jgarcia-dec/sensor-calidad-suelo-TEI201/hardware/fotos (OK)/Vista_isométrica.jpg

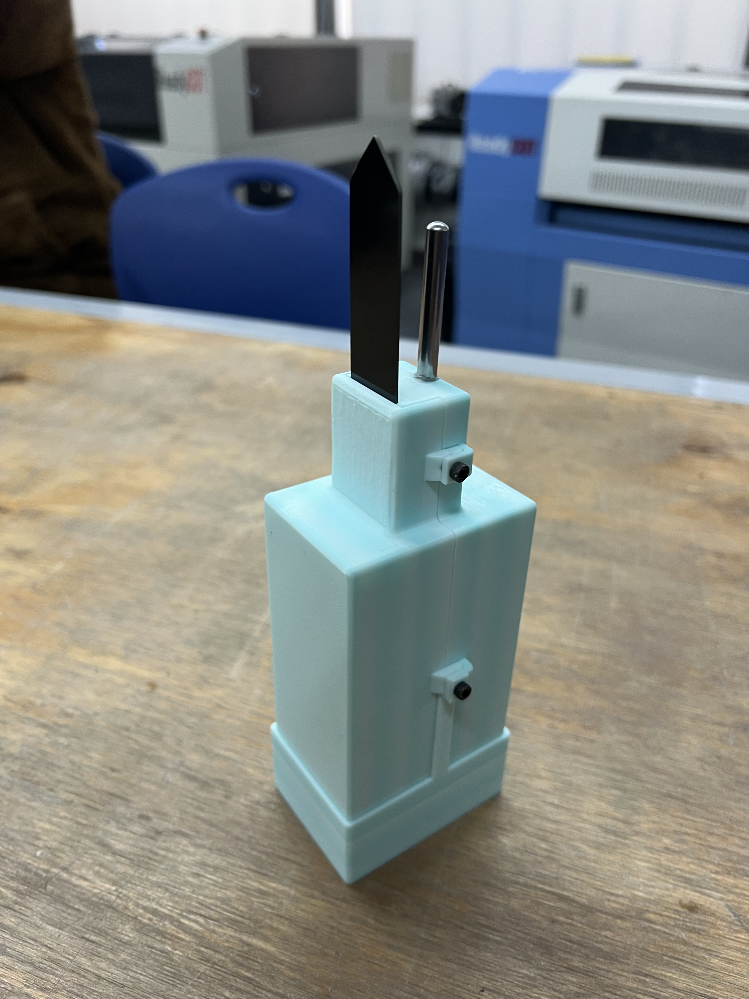
hardware/fotos (OK)/Vista_isométrica.jpg
