jgarcia-dec/sensor-calidad-suelo-TEI201/hardware/fotos (OK)/Vista_general.jpg

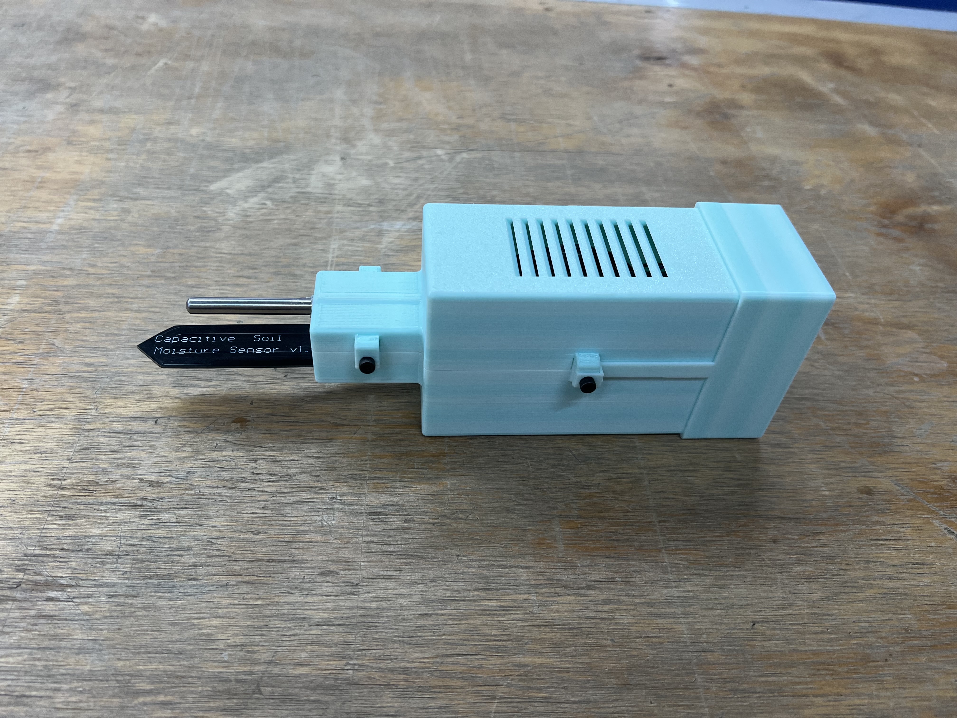
hardware/fotos (OK)/Vista_general.jpg
