jgarcia-dec/sensor-calidad-suelo-TEI201/diseno-3d/renders (OK)/README.md

# Renders de Alta Calidad

## Renders incluidos

### 01_isometrica_exterior_v3.png

Vista isométrica del prototipo completamente ensamblado. Permite observar el encapsulado, la distribución general del sistema y la integración de los componentes electrónicos.

---
  
### 02_vista_interior_v3.png
  
  Vista interna del dispositivo donde se aprecia la ubicación del ESP32-S3, la batería, el sensor capacitivo SEN0193 y el sensor de temperatura DS18B20 dentro del encapsulado.

---
  
### 03_ensamble_explosionada_v3.png
  
  Vista explosionada del sistema que muestra el orden de ensamblaje y la relación entre los distintos componentes mecánicos y electrónicos.

Componentes visibles:
- Encapsulado superior
- Encapsulado inferior
- ESP32-S3 DevKit
- Batería
- Sensor capacitivo SEN0193
- Sensor de temperatura DS18B20
- Protector frontal

---
  
### 04_vista_lateral_v3.png
  
  Vista lateral del dispositivo ensamblado. Permite observar el perfil del encapsulado, la posición del sensor capacitivo y la distribución externa de los componentes.

---
  
### 05_vista_superior_v3.png
  
  Vista superior del prototipo ensamblado. Destaca las ranuras de ventilación del encapsulado y la disposición general del diseño desde la parte superior.

---
  
# Configuración de Render
  
  | Parámetro | Valor |
  |-----------|-------|
  | Software | Autodesk Fusion 360 |
  | Motor de render | Renderizador local |
  | Resolución | 1920 × 1080 px |
  | Calidad | Final |
  | Fondo | Gris neutro |
  | Formato | PNG |
  
  ---
  
# Materiales y Apariencias
  
  | Componente | Material |
  |------------|----------|
  | Encapsulado | PLA |
  | Protector frontal | PLA |
  | ESP32-S3 | PCB FR-4 |
  | Sensor SEN0193 | PCB |
  | Sensor DS18B20 | Acero inoxidable y plástico |
  | Batería | Li-ion |
  
  ---
  
# Nomenclatura de Archivos
  
  ```
01_isometrica_exterior_v3.png
02_vista_interior_v3.png
03_ensamble_explosionada_v3.png
04_vista_lateral_v3.png
05_vista_superior_v3.png
```

---
  
# Checklist de Calidad
  
- ✅ Resolución mínima 1920 × 1080
- ✅ Formato PNG
- ✅ Iluminación uniforme
- ✅ Fondo neutro
- ✅ Vista isométrica exterior
- ✅ Vista interior
- ✅ Vista explosionada
- ✅ Vista lateral
- ✅ Vista superior
- ✅ Componentes principales claramente visibles
