jgarcia-dec/sensor-calidad-suelo-TEI201/diseno-3d/planos/Protector del cableado trasero.pdf

54.1

31.5

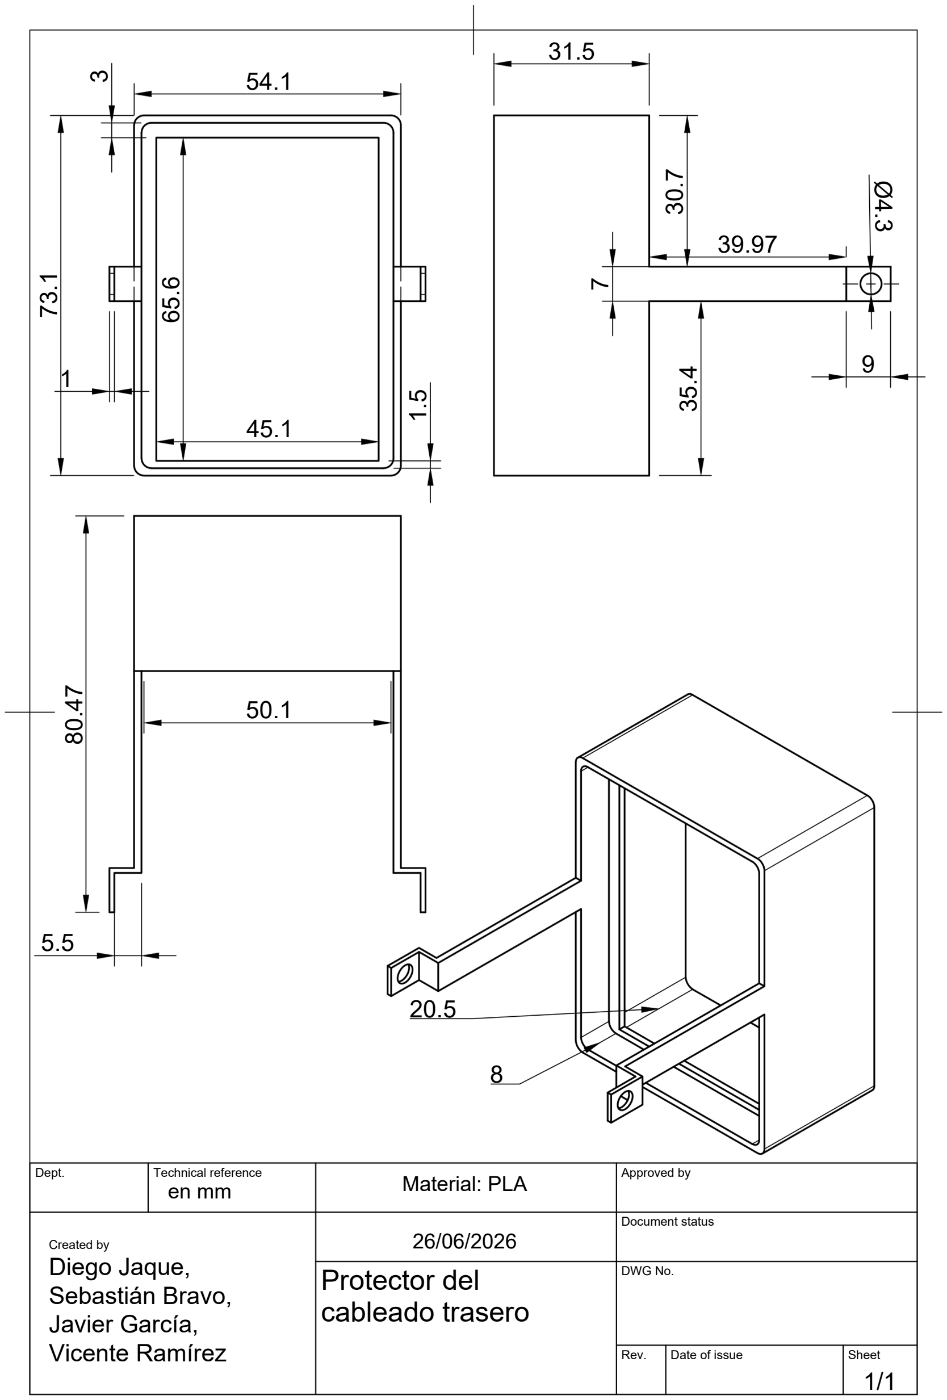
[picture p11: page 1]

Dept. | Technical reference

Rev.

DWG No.

Approved by

Document status

Date of issue | Sheet

1

5.5

50.1

45.1

20.5

8

Created by
Diego Jaque,
Sebastián Bravo,
Javier García,

# Vicente Ramírez

39.97

9

1/1

# Protector del cableado trasero

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
en mm | Material: PLA
| 26/06/2026
