jgarcia-dec/sensor-calidad-suelo-TEI201/diseno-3d/planos/Soporte.pdf.pdf

20.11

2

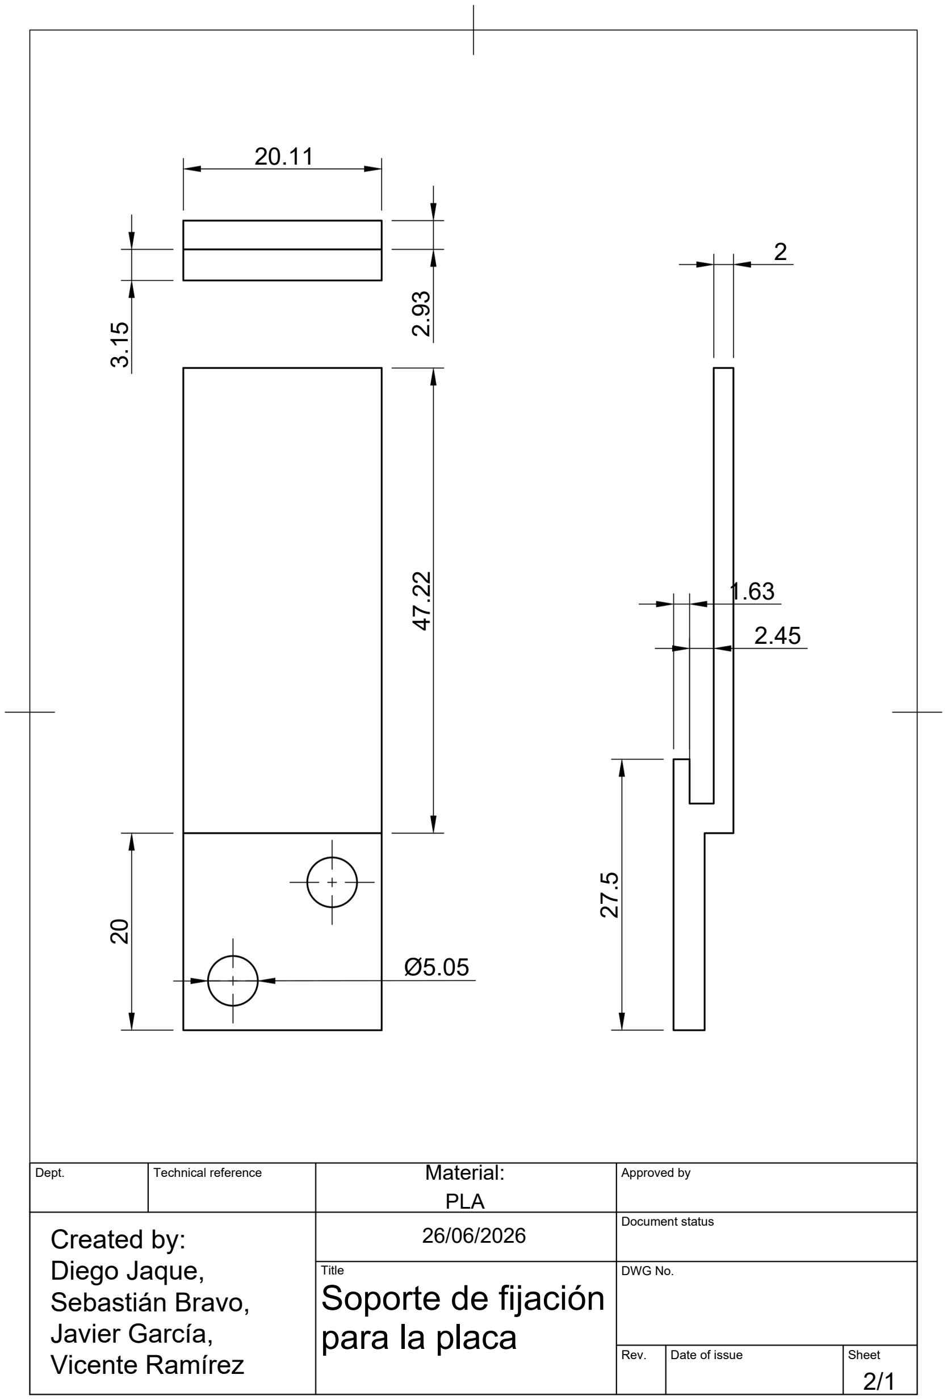
[picture p12: page 1]

Dept. | Technical reference

Rev.

DWG No.

Approved by

Document status

Date of issue | Sheet

Ø5.05

# Created by:

Diego Jaque,
Sebastián Bravo,
Javier García,

# Vicente Ramírez

1.63
2.45

2/1

Title

# Soporte de fijación para la placa

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
## Material: PLA

26/06/2026
