jgarcia-dec/sensor-calidad-suelo-TEI201/diseno-3d/planos/Tapa superior.pdf

5.5

2.3

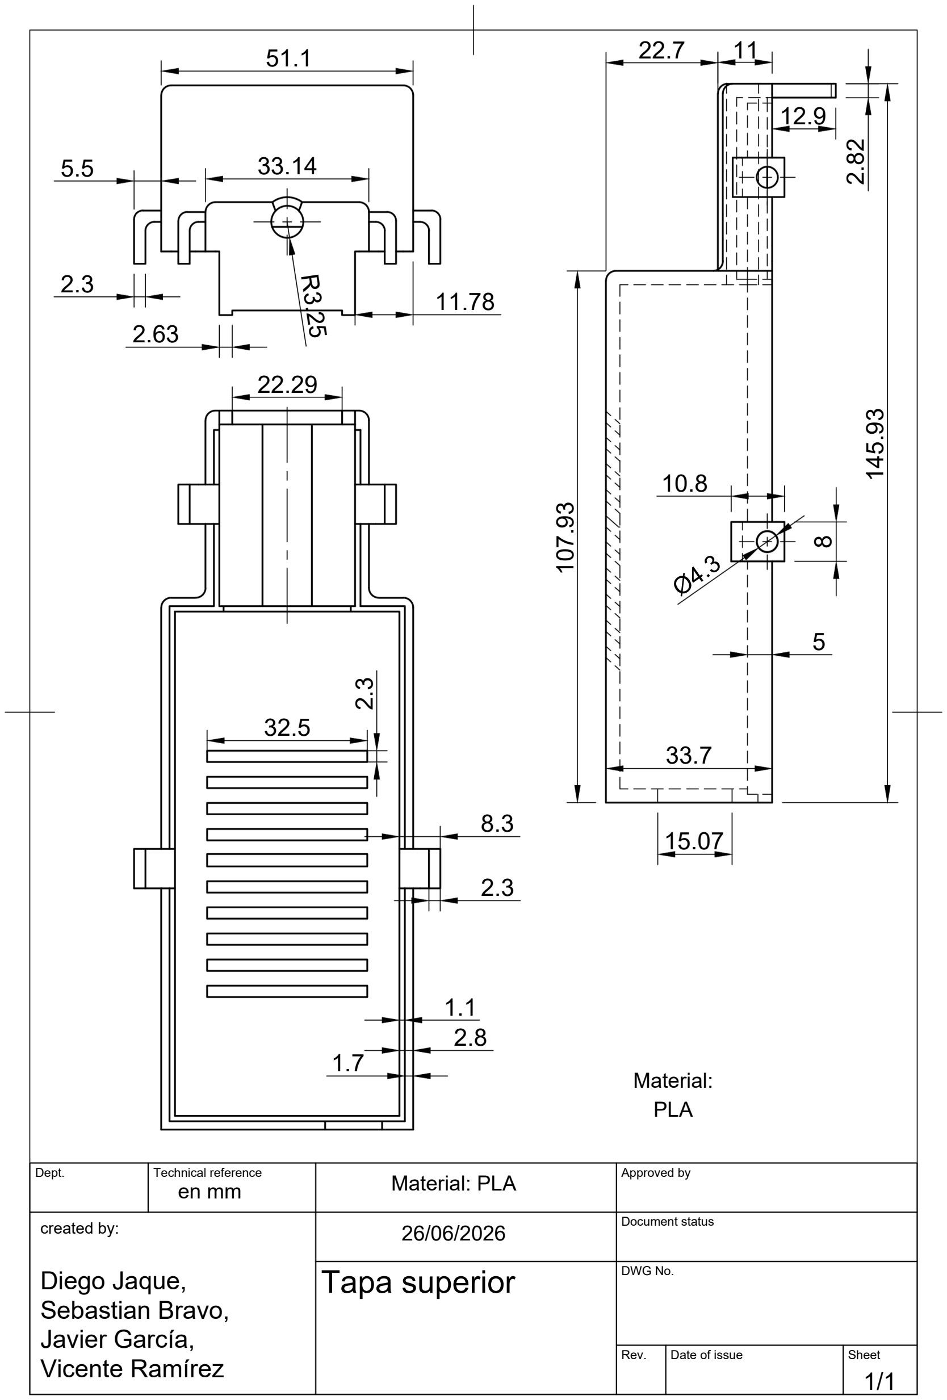
[picture p13: page 1]

Dept. | Technical reference

Rev.

DWG No.

Approved by

Document status

Date of issue | Sheet

2.63

32.5

51.1

33.14

22.29

1.7

1.1
2.8

11.78

8.3

2.3

### created by:

Diego Jaque,
Sebastian Bravo,
Javier García,

# Vicente Ramírez

22.7

10.8

33.7

15.07

5

11

12.9

1/1

# Tapa superior

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
Ø4.3

R3

25

## en mm

26/06/2026

## Material: PLA

## Material: PLA
