jgarcia-dec/sensor-calidad-suelo-TEI201/docs/presentacion/MONITOR_VERDE_V3.pdf

# MONITOR

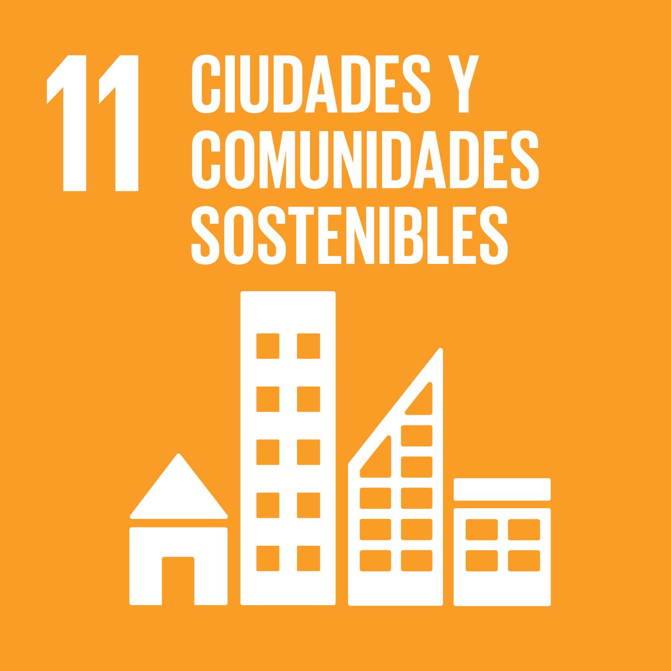
[picture p14: figure]

# VERDE

TEI201 — Taller de Diseño en Ingeniería Design Engineering Center· Universidad Adolfo Ibáñez

Profesor: Sebastián Duarte Villanueva (https://webc.uai.cl/user/profile.php?id=402649) Ayudante: Fernando Mendez Carballo Grupo: 2
Integrantes:
- Sebastián Bravo
- Javier García
- Diego Jaque
- Vicente Ramírez

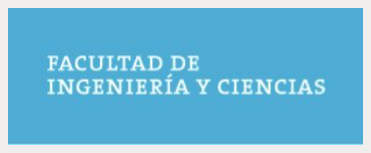
[picture p15: figure]
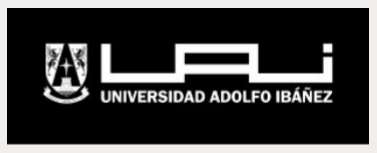
[picture p16: figure]

# PROBLEMA

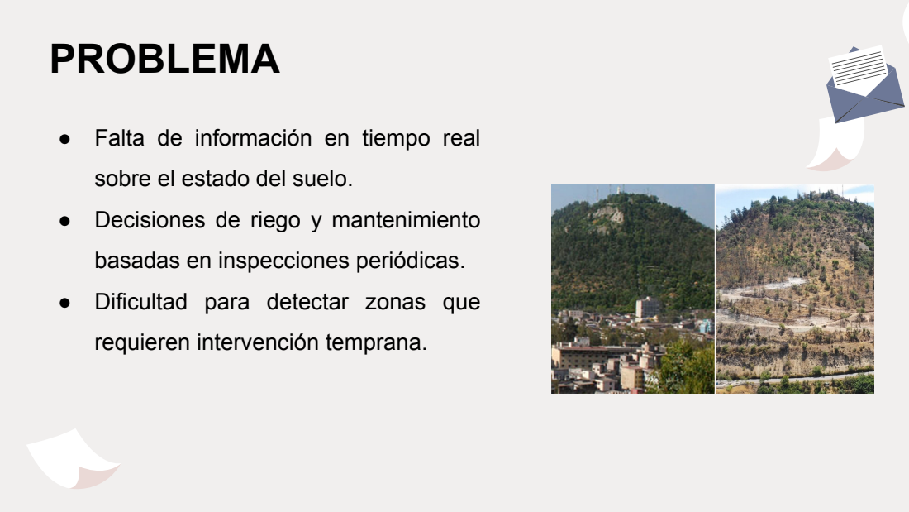
[picture p17: page 2]

● Falta de información en tiempo real

sobre el estado del suelo.

● Decisiones de riego y mantenimiento

basadas en inspecciones periódicas.
● Dificultad para detectar zonas que

requieren intervención temprana.

# PROBLEMA

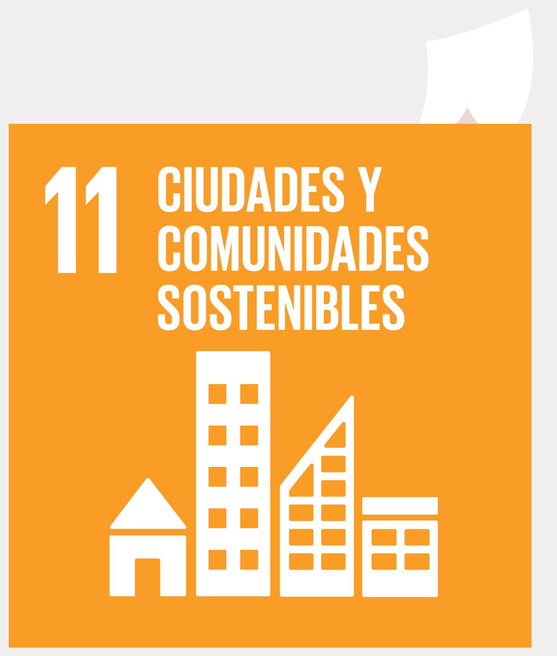
[picture p18: figure]
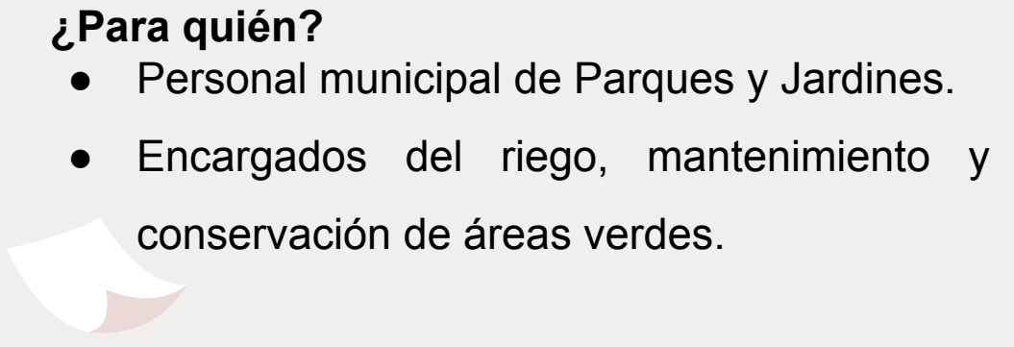
[picture p19: figure]
¿Para quién?; ● Encargados del riego, mantenimiento y; conservación de áreas verdes.

- Personal municipal de Parques y Jardines.

¿Qué resolvemos?
- Monitoreo en tiempo real de humedad y

temperatura del suelo.

- Apoyo a la toma de decisiones basada en datos.

# SOLUCIÓN

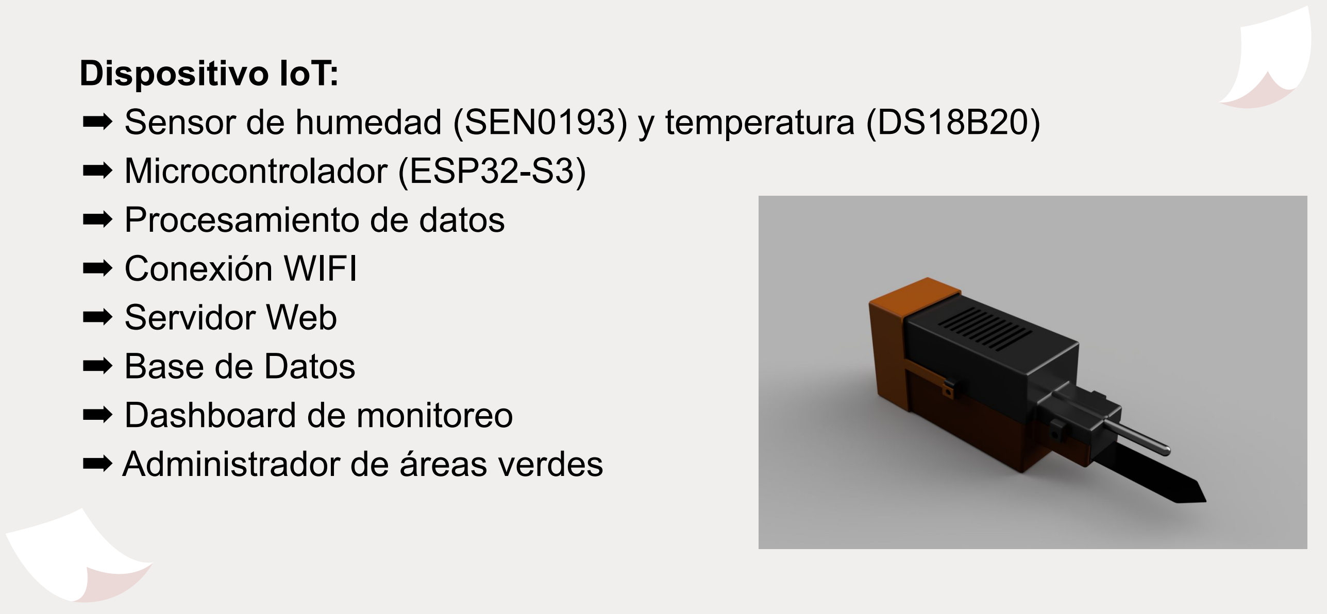
[picture p20: figure]
Dispositivo IoT:; ➡ Microcontrolador (ESP32-S3) ➡ Procesamiento de datos ➡ Conexión WIFI ➡ Servidor Web ➡ Base de Datos ➡ Dashboard de monitoreo ➡ Administrador de áreas verdes

➡ Sensor de humedad (SEN0193) y temperatura (DS18B20)

# HARDWARE

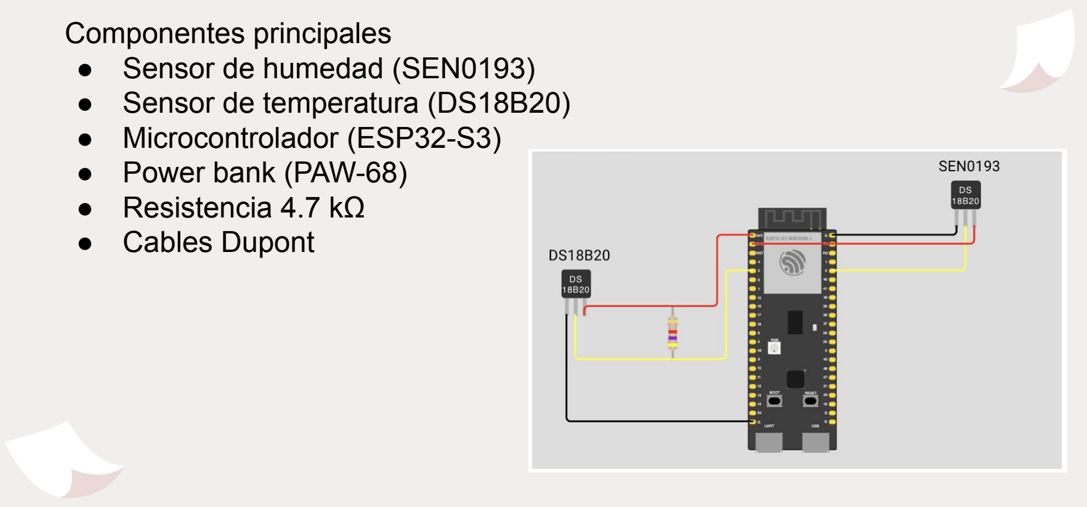
[picture p21: figure]
Componentes principales ● Sensor de humedad (SEN0193) ● Sensor de temperatura (DS18B20) ● Microcontrolador (ESP32-S3) ● Power bank (PAW-68) ● Resistencia 4.7 kΩ ● Cables Dupont

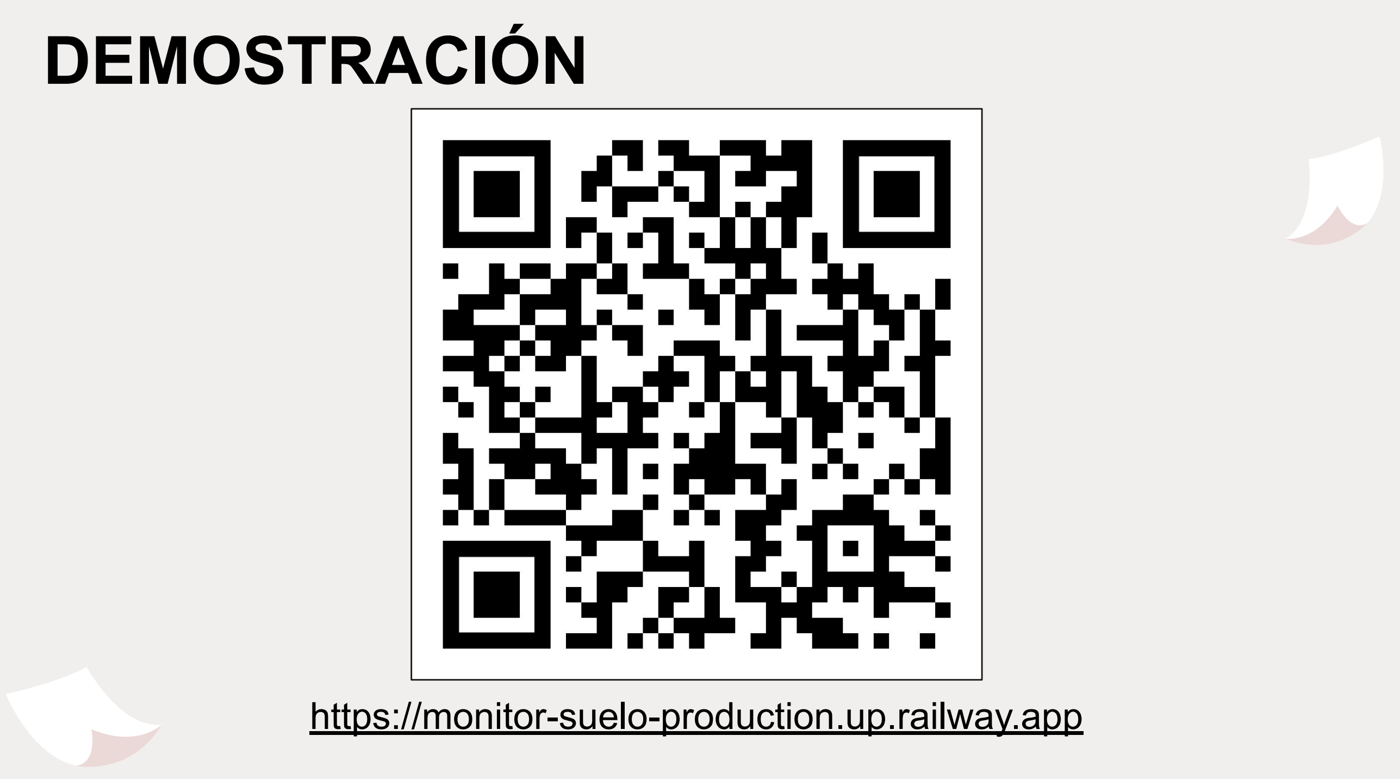
[picture p22: figure]
DEMOSTRACIÓN; https://monitor-suelo-production.up.railway.app

# DISEÑO 3D

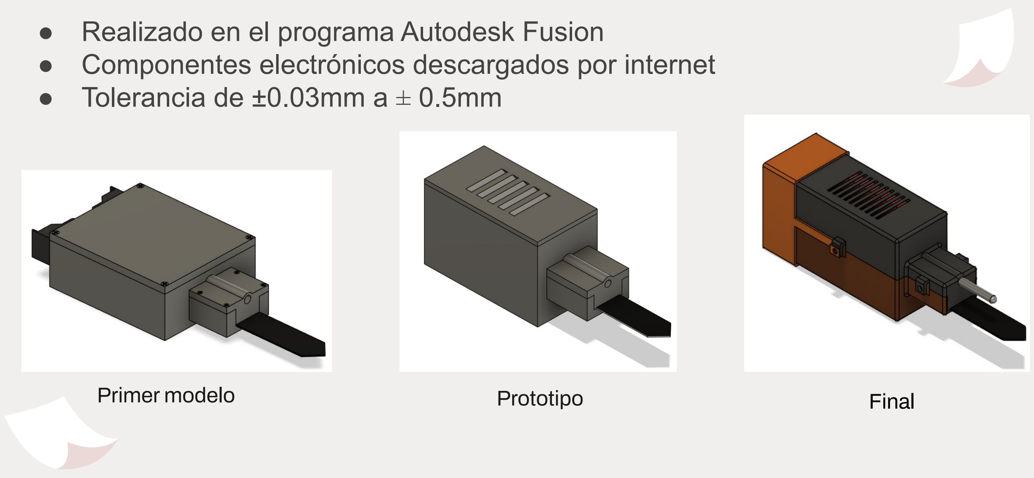
[picture p23: figure]
Primer modelo; Prototipo; Final; ● Tolerancia de ±0.03mm a ± 0.5mm

- Realizado en el programa Autodesk Fusion
- Componentes electrónicos descargados por internet

# MODELOS 3D

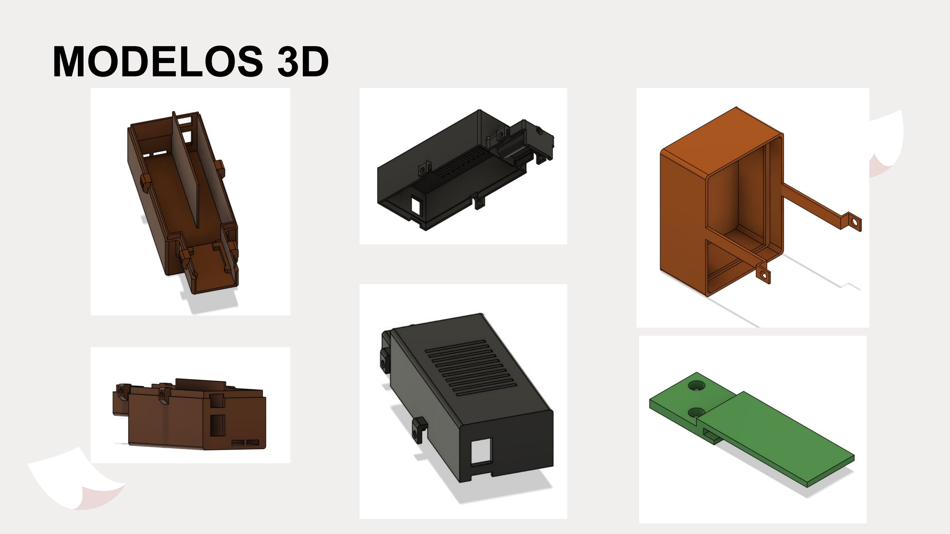
[picture p24: page 8]
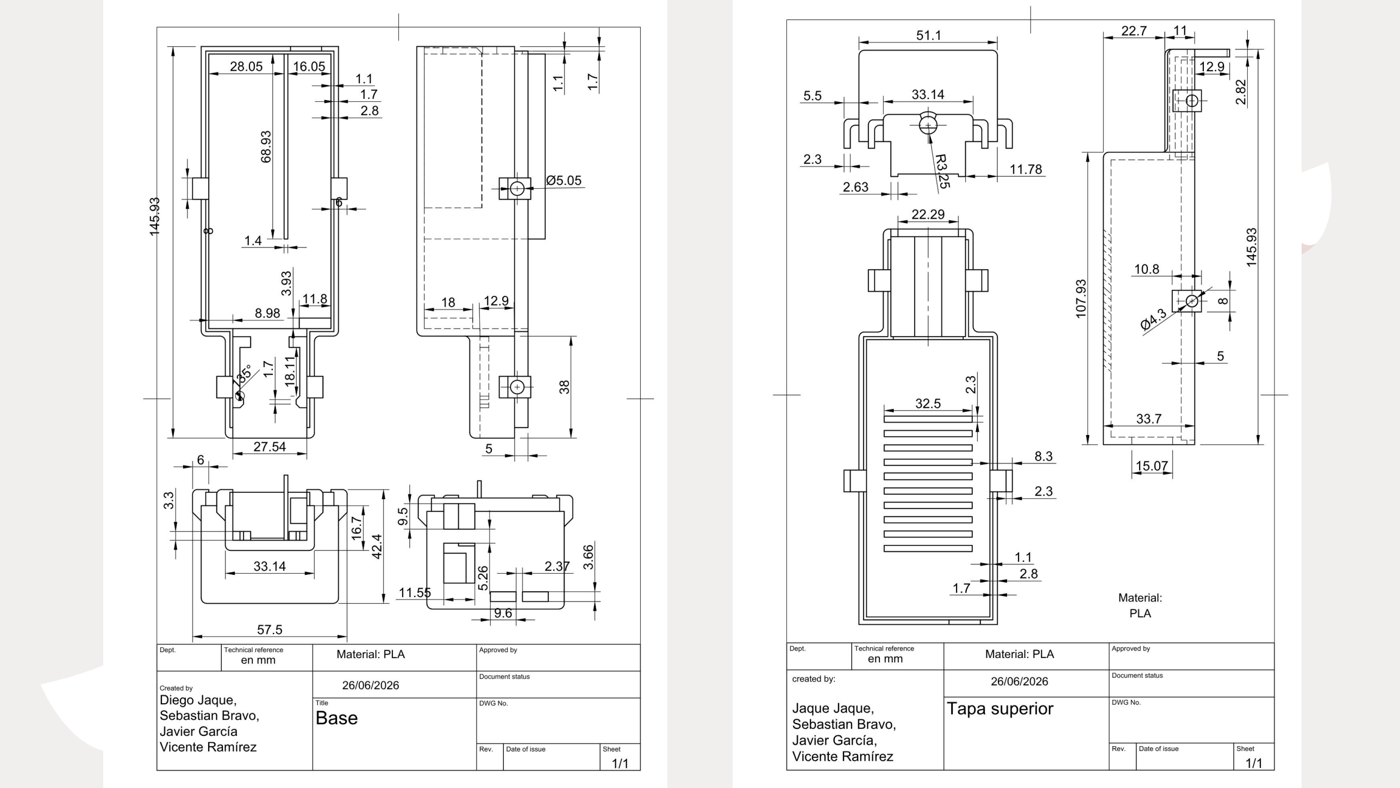
[picture p25: page 9]
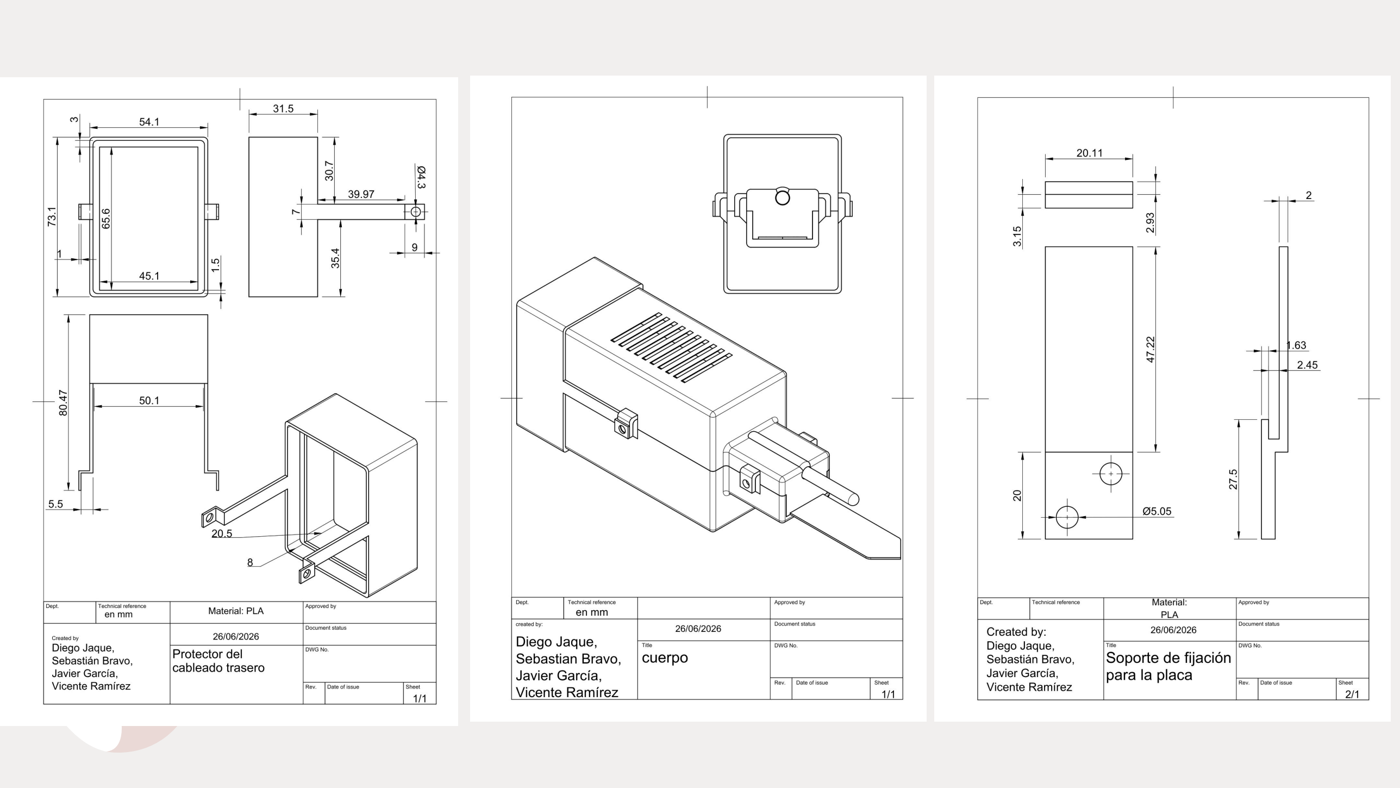
[picture p26: page 10]

# GITHUB

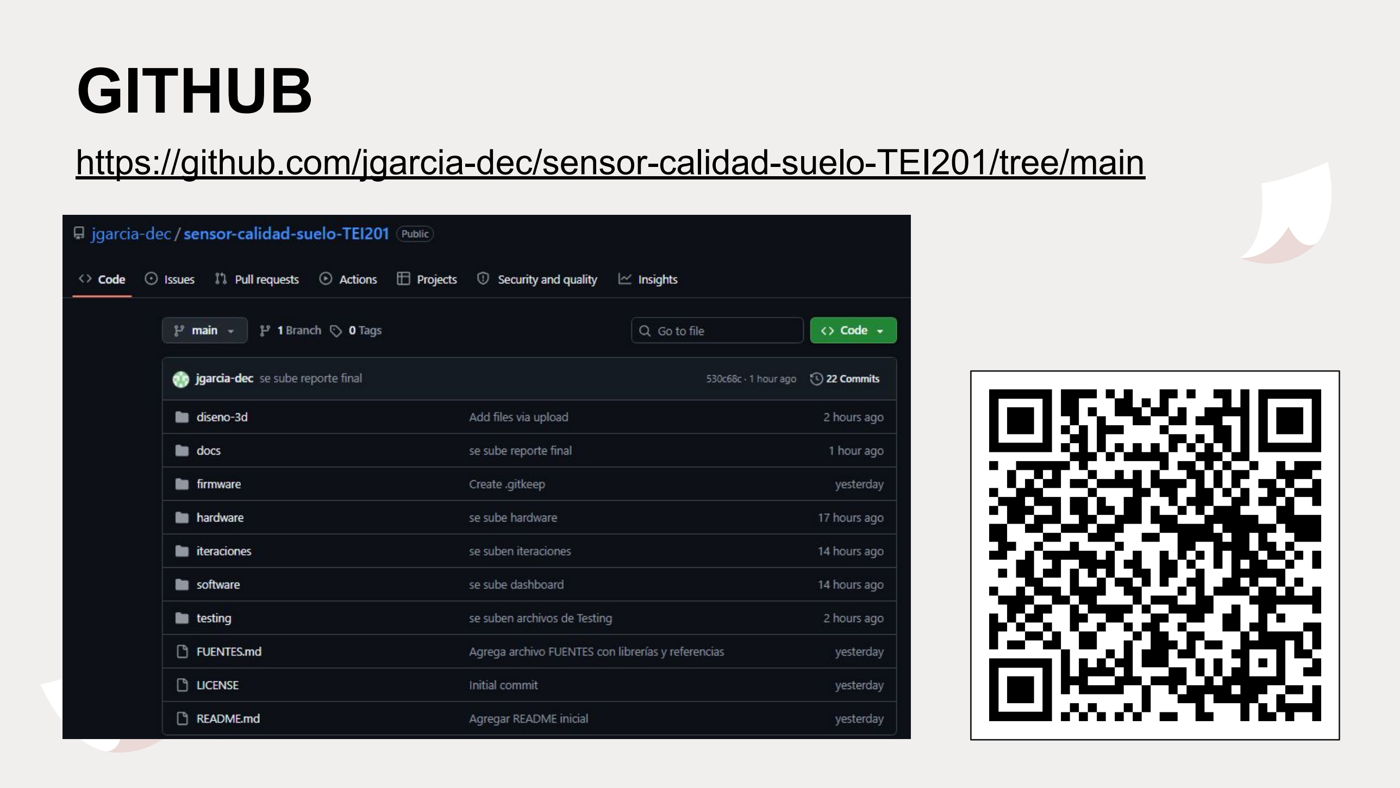
[picture p27: page 11]

https://github.com/jgarcia-dec/sensor-calidad-suelo-TEI201/tree/main

# Librerias de codigo

1. Arduino: Provee las funciones más esenciales como setup(), loop(), digitalWrite(), delay(), etc. Sin ella, el código no funciona.
2. OneWire: Este protocolo permite conectar múltiples sensores usando un solo cable de datos
3. DallasTemperature: esta librería facilita la lectura del sensor de temperatura DS18B20
4. WiFi: Permite conectar el ESP32 a una red WiFi
5. HTTPClient: Facilita hacer peticiones HTTP (como POST o GET) desde el ESP32 hacia un servidor
6. WiFiClientSecure: Es una versión extendida del cliente WiFi que soporta conexiones HTTPS (cifradas con SSL/TLS). Se usa cuando el servidor al que te conectas tiene un certificado de seguridad, como ocurre cuando el servidor está en la nube o detrás de un dominio con https://.

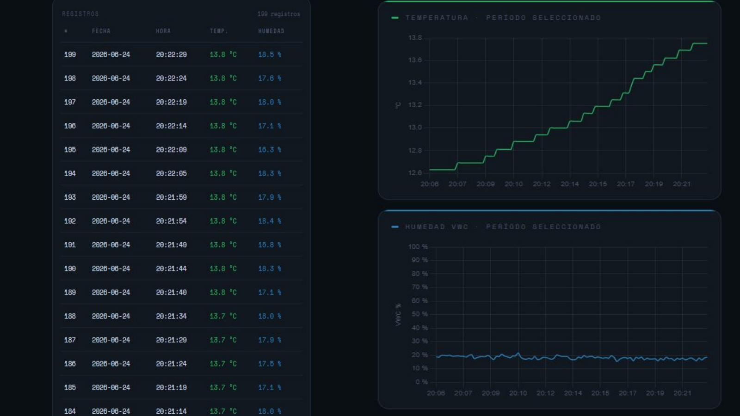
[picture p28: page 13]
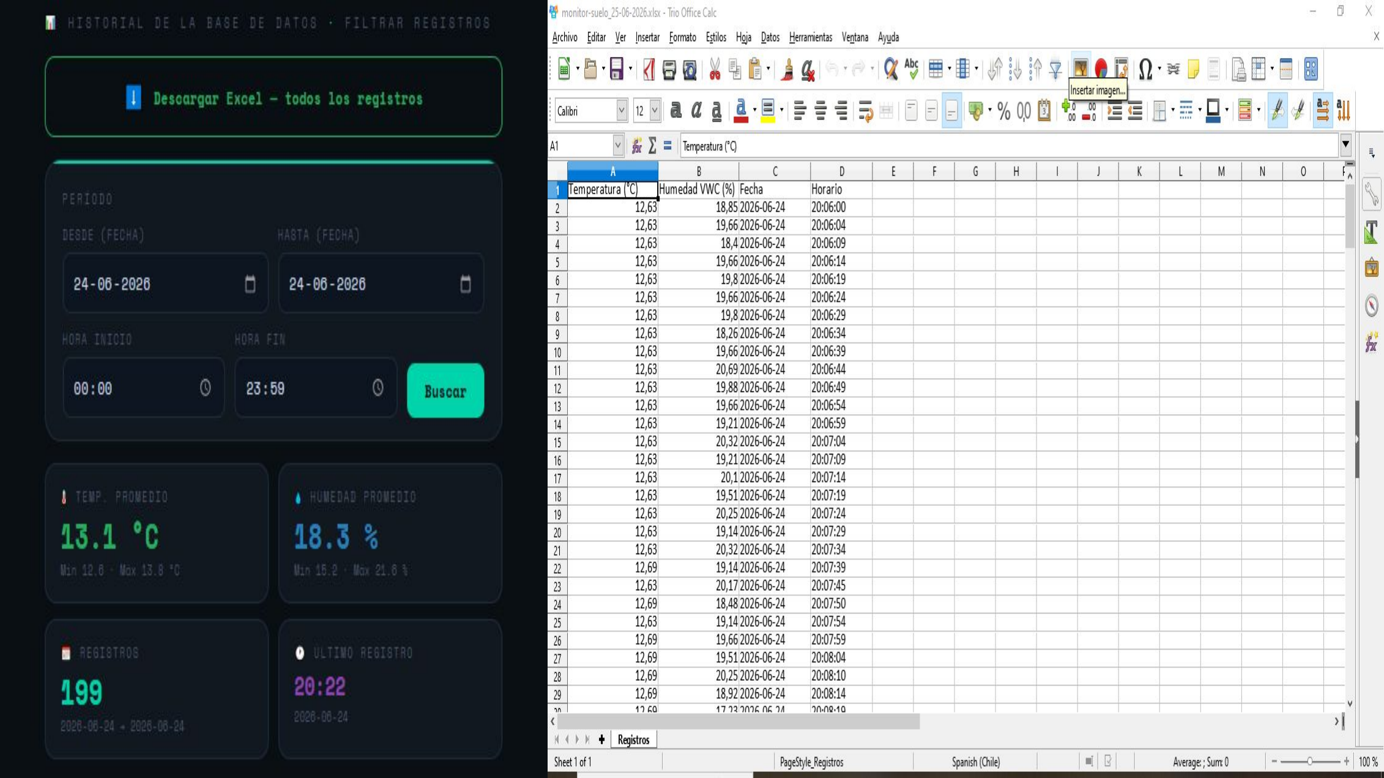
[picture p29: page 14]

# ¿PREGUNTAS?
