jgarcia-dec/sensor-calidad-suelo-TEI201/diseno-3d/planos/Base.pdf

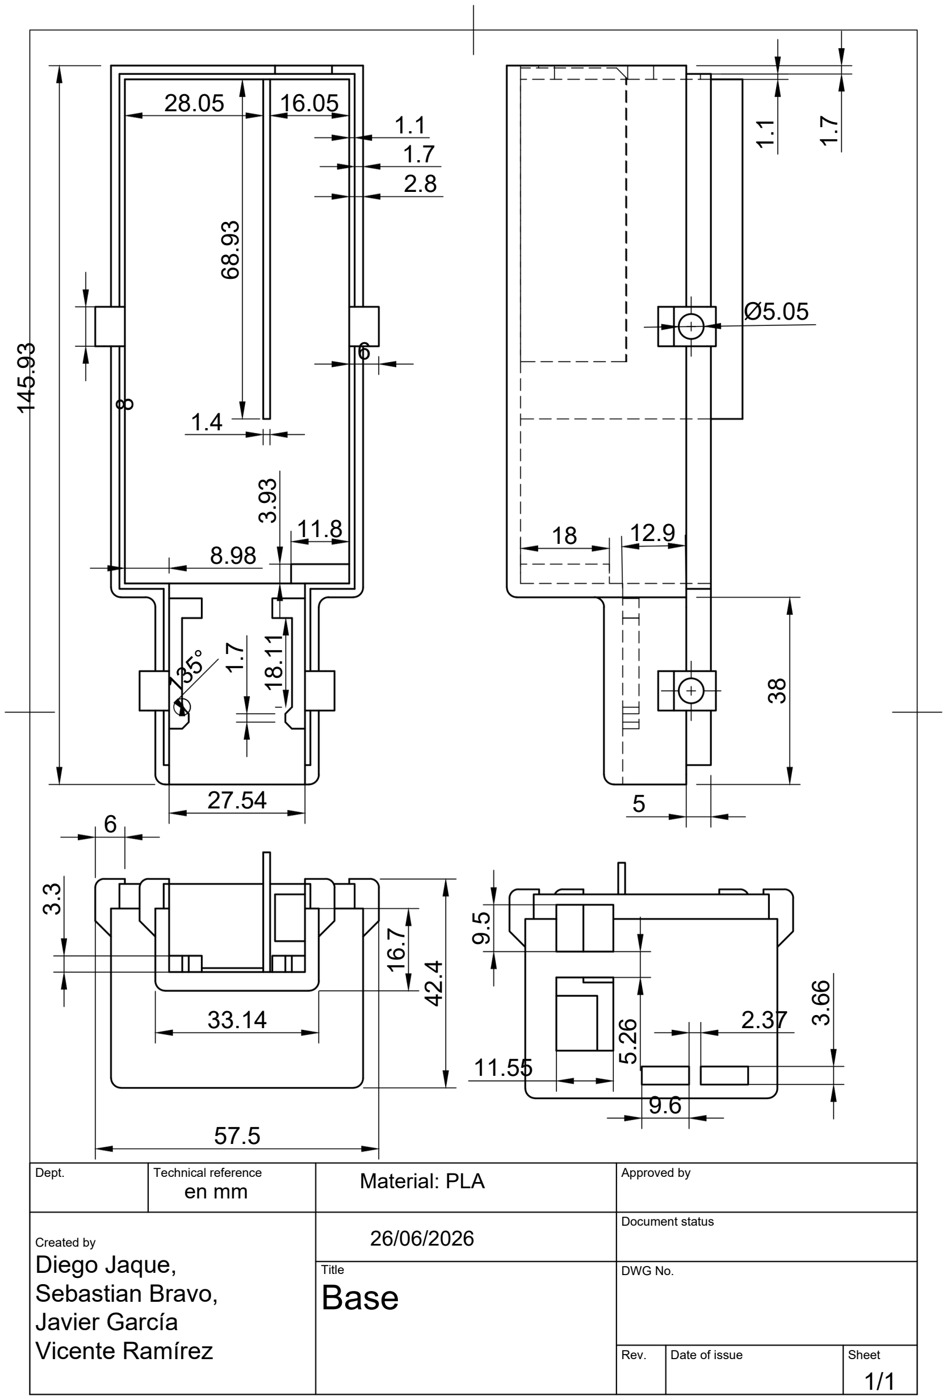
[picture p43: page 1]

Dept. | Technical reference

Rev.

DWG No.

Approved by

Document status

Date of issue | Sheet

6

1.4

28.05

8.98

57.5

33.14

27.54

16.05

11.8

6

1.1
1.7
2.8

11.55

18

Created by
Diego Jaque,
Sebastian Bravo,
Javier García
Vicente Ramírez

5

12.9

9.6

2.37

Ø5.05

1/1

Title

## Base

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
135°

en mm

Material: PLA

26/06/2026
