jgarcia-dec/sensor-calidad-suelo-TEI201/iteraciones/iteracion-1/v1_circuito_protoboard.jpeg

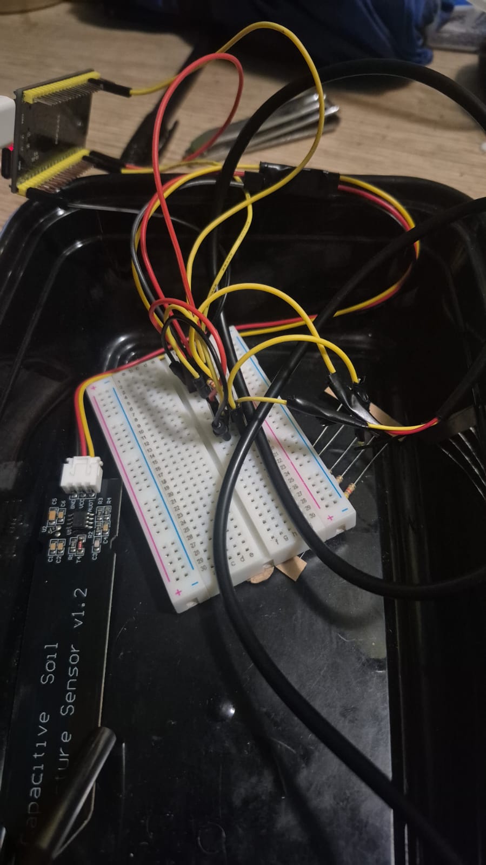
iteraciones/iteracion-1/v1_circuito_protoboard.jpeg
