jgarcia-dec/sensor-calidad-suelo-TEI201/iteraciones/iteracion-1/v1_detalle_conexiones.jpeg

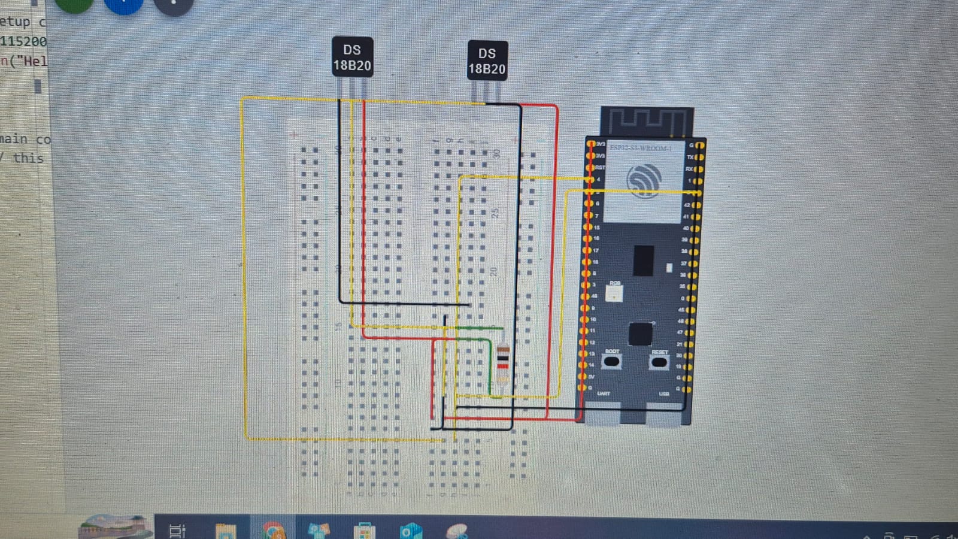
iteraciones/iteracion-1/v1_detalle_conexiones.jpeg
