jgarcia-dec/sensor-calidad-suelo-TEI201/iteraciones/iteracion-2/v2_cuerpo_superior.jpeg

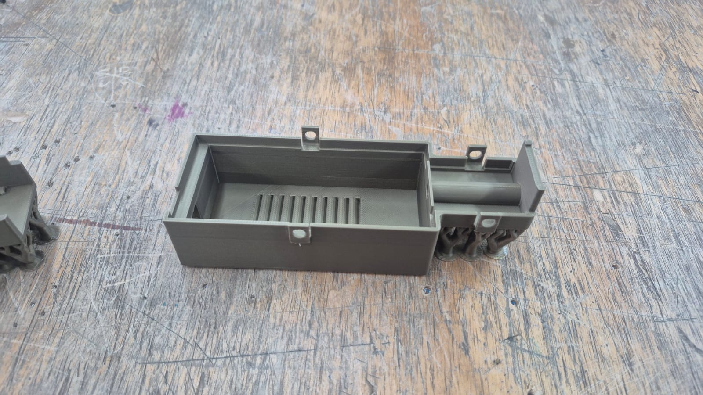
iteraciones/iteracion-2/v2_cuerpo_superior.jpeg
