jgarcia-dec/sensor-calidad-suelo-TEI201/iteraciones/iteracion-2/v2_detalle_conexiones.jpeg

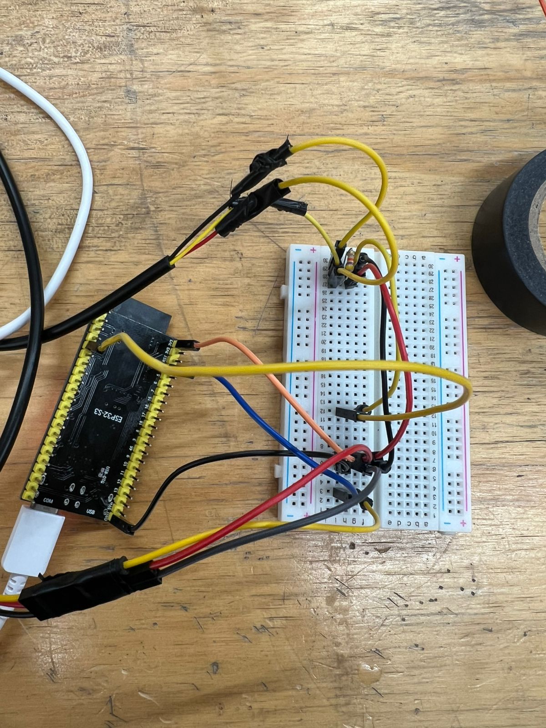
iteraciones/iteracion-2/v2_detalle_conexiones.jpeg
