jgarcia-dec/sensor-calidad-suelo-TEI201/iteraciones/iteracion-3/v3_prototipo_superior.jpg

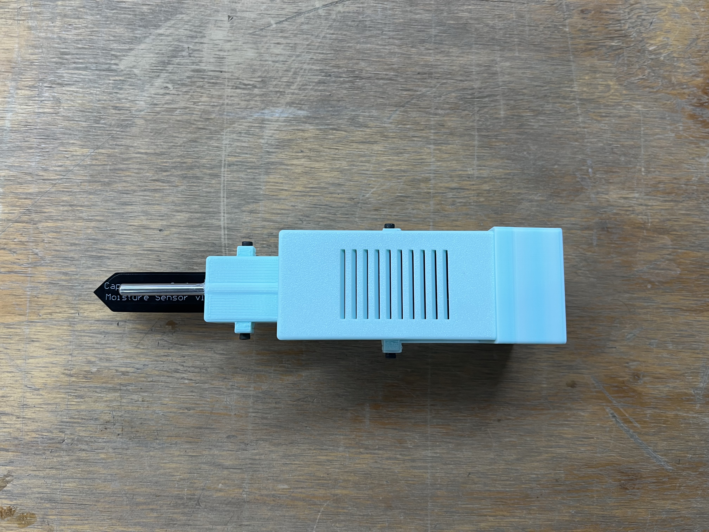
iteraciones/iteracion-3/v3_prototipo_superior.jpg
