jgarcia-dec/sensor-calidad-suelo-TEI201/software/Docs (OK)/diagrama.png

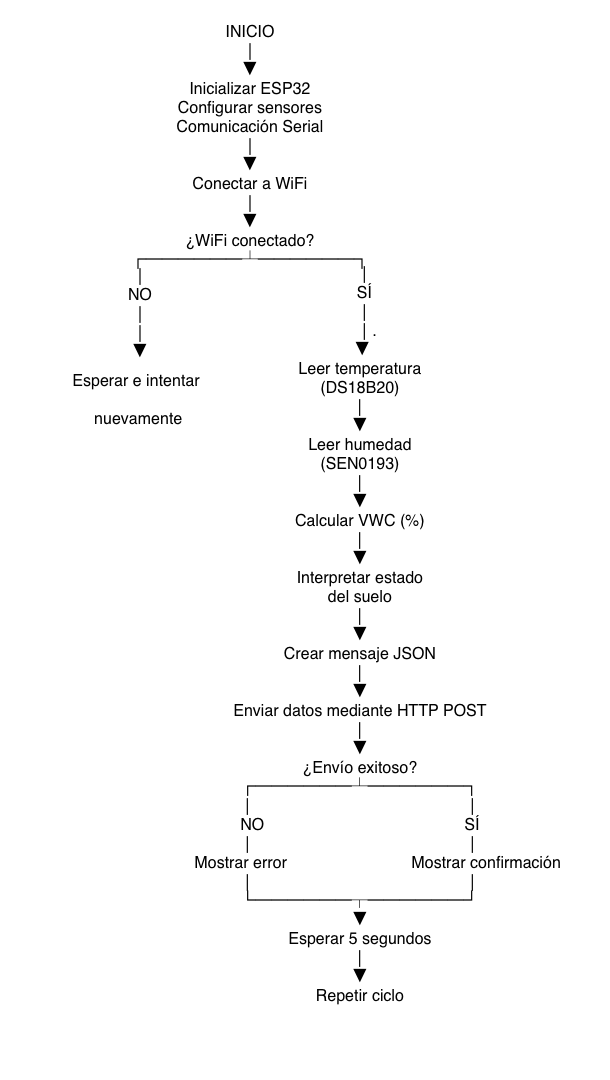
software/Docs (OK)/diagrama.png
