jgarcia-dec/sensor-calidad-suelo-TEI201/hardware/bom (OK)/BOM  (Software).xlsx

BILL OF MATERIALS (BOM) |  | Ítem | Componente | Fabricante | Código / SKU | Proveedor | Especificación | Cantidad | Costo unitario (CLP) | Costo total (CLP)
Proyecto: | Sensor IoT de Humedad y Temperatura del Suelo | 1 | ESP32 | Espressif |  | Universidad Adolfo Ibáñez | Microcontrolador con WiFi y Bluetooth, alimentación 3.3 V | 1 | $8000 | $8000
Versión: | 1.0 | 2 | Sensor de humedad de suelo | DFRobot | SEN0193 | Universidad Adolfo Ibáñez | Sensor capacitivo v1.2, alimentación 3.3–5.0 V, salida analógica | 1 | $2776 | $2776
Fecha: | 25 de junio de 2026 | 3 | Sensor de temperatura | Maxim Integrated | DS18B20 | Universidad Adolfo Ibáñez | DS18B20, alimentación 3.0–5.5 V, rango −55 °C a 125 °C | 1 | $2500 | $2500
Curso: | Taller de Diseño en Ingeniería, Sección 2 | 4 | Módulo de alimentación |  | PAW-68 | Universidad Adolfo Ibáñez | PAW-68, batería/cargador portátil, voltaje nominal 3.7 V | 1 | $7990 | $7990
Institución: | Universidad Adolfo Ibañez | 5 | Resistencia | No aplica | No aplica | Universidad Adolfo Ibáñez | 4.7 kΩ (4700 Ω), 1/4 W, ±5 % | 1 | $1098 | $1098
Docente: | Sebastián Duarte | 6 | Cable USB | No aplica | No aplica | Universidad Adolfo Ibáñez | USB-A a USB-C para alimentación y programación | 1 | $1000 | $1000
Responsables: | Ramírez V., Bravo S., García J., Jaque D. | 7 | Cable Dupont | No aplica | No aplica | Universidad Adolfo Ibáñez | Cable de conexión macho-hembra | 6 | $50 | $300
 |  |  |  |  |  |  |  |  | TOTAL | $23664
