jgarcia-dec/sensor-calidad-suelo-TEI201/hardware/bom (OK)/BOM .pdf

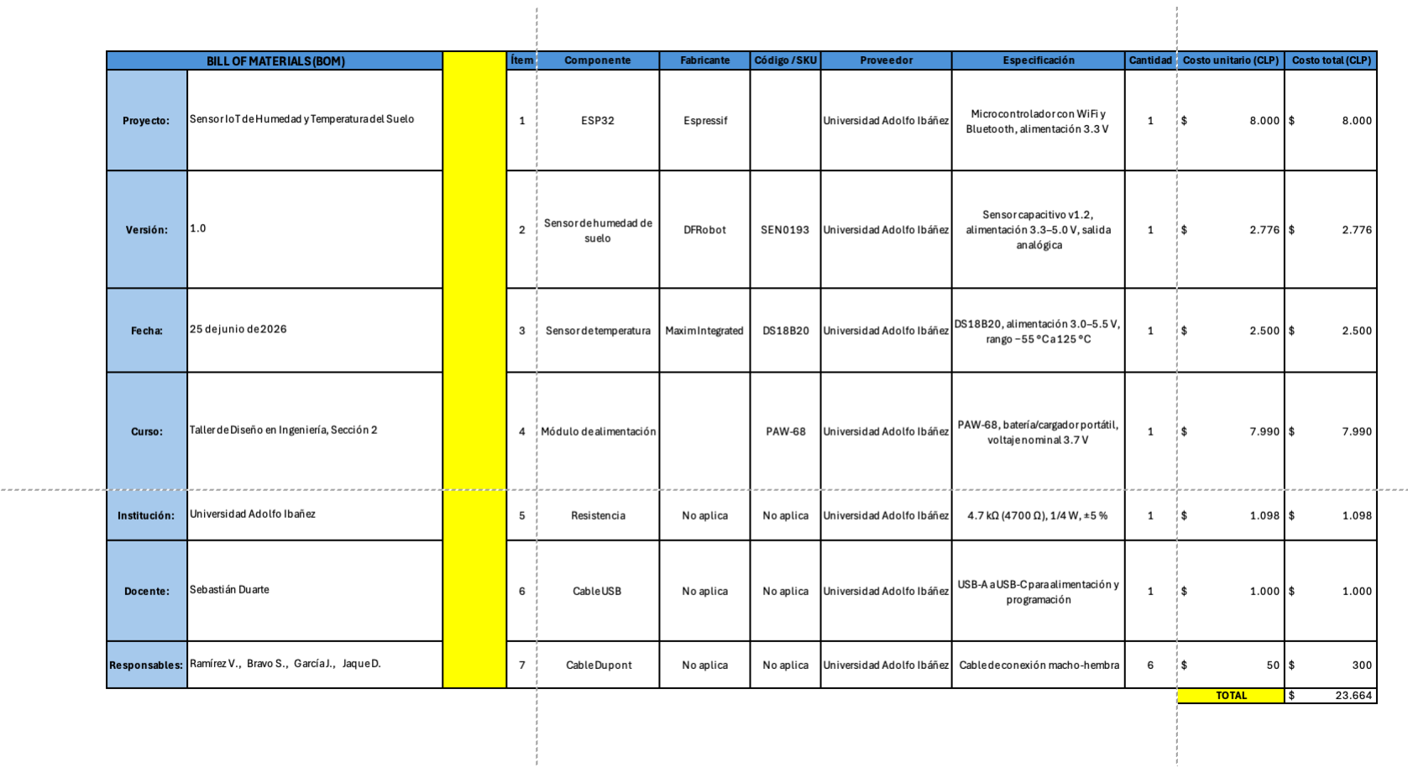
[picture p55: page 1]
