jgarcia-dec/sensor-calidad-suelo-TEI201/iteraciones/iteracion-3/v3_componentes_internos.jpeg

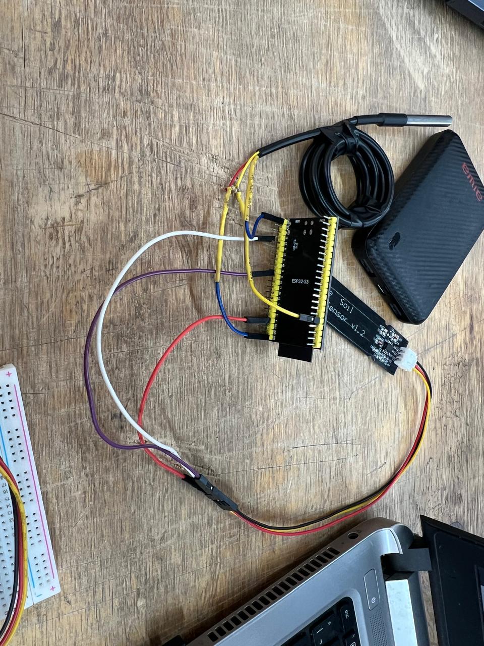
iteraciones/iteracion-3/v3_componentes_internos.jpeg
