jgarcia-dec/sensor-calidad-suelo-TEI201/diseno-3d/renders (OK)/renders_fusion/03_ensamble_explosionada_v3.png

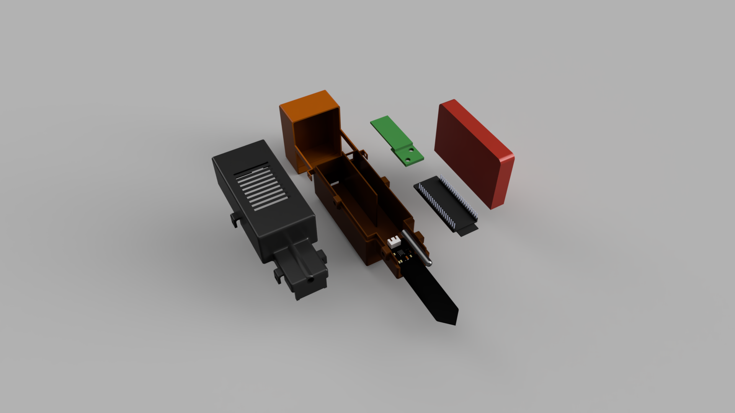
diseno-3d/renders (OK)/renders_fusion/03_ensamble_explosionada_v3.png
