jgarcia-dec/sensor-calidad-suelo-TEI201/testing/Datos/monitor-suelo_25-06-2026.xlsx

Temperatura (°C) | Humedad VWC (%) | Fecha | Horario
12.63 | 18.85 | 2026-06-24 | 20:06:00
12.63 | 19.66 | 2026-06-24 | 20:06:04
12.63 | 18.4 | 2026-06-24 | 20:06:09
12.63 | 19.66 | 2026-06-24 | 20:06:14
12.63 | 19.8 | 2026-06-24 | 20:06:19
12.63 | 19.66 | 2026-06-24 | 20:06:24
12.63 | 19.8 | 2026-06-24 | 20:06:29
12.63 | 18.26 | 2026-06-24 | 20:06:34
12.63 | 19.66 | 2026-06-24 | 20:06:39
12.63 | 20.69 | 2026-06-24 | 20:06:44
12.63 | 19.88 | 2026-06-24 | 20:06:49
12.63 | 19.66 | 2026-06-24 | 20:06:54
12.63 | 19.21 | 2026-06-24 | 20:06:59
12.63 | 20.32 | 2026-06-24 | 20:07:04
12.63 | 19.21 | 2026-06-24 | 20:07:09
12.63 | 20.1 | 2026-06-24 | 20:07:14
12.63 | 19.51 | 2026-06-24 | 20:07:19
12.63 | 20.25 | 2026-06-24 | 20:07:24
12.63 | 19.14 | 2026-06-24 | 20:07:29
12.63 | 20.32 | 2026-06-24 | 20:07:34
12.69 | 19.14 | 2026-06-24 | 20:07:39
12.63 | 20.17 | 2026-06-24 | 20:07:45
12.69 | 18.48 | 2026-06-24 | 20:07:50
12.63 | 19.14 | 2026-06-24 | 20:07:54
12.69 | 19.66 | 2026-06-24 | 20:07:59
12.69 | 19.51 | 2026-06-24 | 20:08:04
12.69 | 20.25 | 2026-06-24 | 20:08:10
12.69 | 18.92 | 2026-06-24 | 20:08:14
12.69 | 17.23 | 2026-06-24 | 20:08:19
12.69 | 18.85 | 2026-06-24 | 20:08:24
12.69 | 18.18 | 2026-06-24 | 20:08:29
12.69 | 20.69 | 2026-06-24 | 20:08:34
12.69 | 18.77 | 2026-06-24 | 20:08:39
12.69 | 17.96 | 2026-06-24 | 20:08:44
12.69 | 18.85 | 2026-06-24 | 20:08:49
12.75 | 18.4 | 2026-06-24 | 20:08:54
12.69 | 18.85 | 2026-06-24 | 20:08:59
12.69 | 19.36 | 2026-06-24 | 20:09:04
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
13.75 | 17.89 | 2026-06-24 | 20:21:59
13.75 | 18.26 | 2026-06-24 | 20:22:05
13.75 | 16.34 | 2026-06-24 | 20:22:09
13.75 | 17.08 | 2026-06-24 | 20:22:14
13.75 | 17.96 | 2026-06-24 | 20:22:19
13.75 | 17.59 | 2026-06-24 | 20:22:24
13.75 | 18.48 | 2026-06-24 | 20:22:29
