jgarcia-dec/sensor-calidad-suelo-TEI201/testing/Evidencias/Dashboard_1-mediciones.jpeg

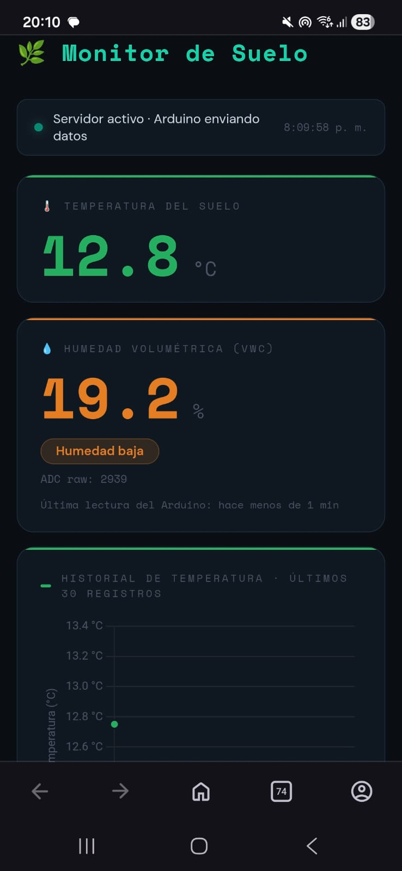
testing/Evidencias/Dashboard_1-mediciones.jpeg
