jgarcia-dec/sensor-calidad-suelo-TEI201/testing/Evidencias/Dashboard_2_graficos.jpeg

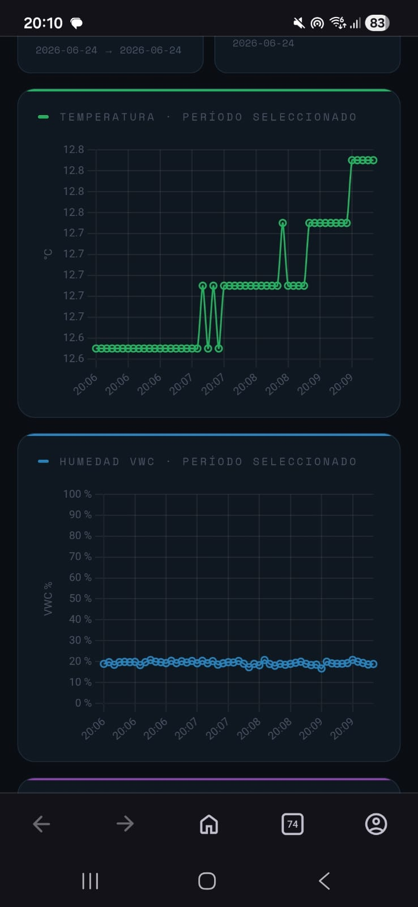
testing/Evidencias/Dashboard_2_graficos.jpeg
