jgarcia-dec/sensor-calidad-suelo-TEI201/testing/Evidencias/Dashboard_3_enlace_base_de_datos.jpeg

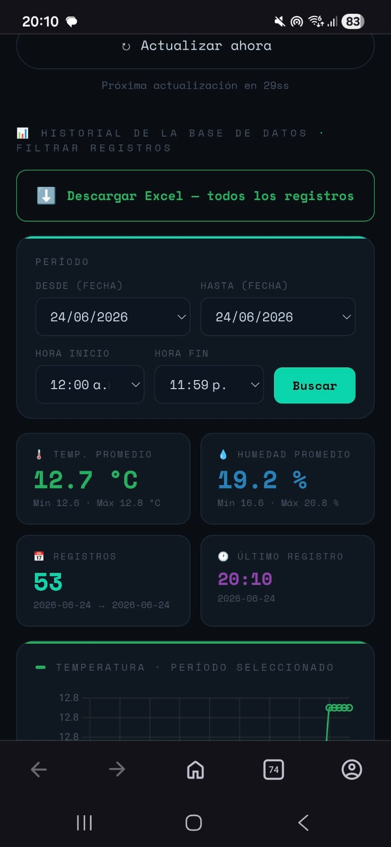
testing/Evidencias/Dashboard_3_enlace_base_de_datos.jpeg
