jgarcia-dec/sensor-calidad-suelo-TEI201/testing/Evidencias/Dashboard_4_meteorologico.jpeg

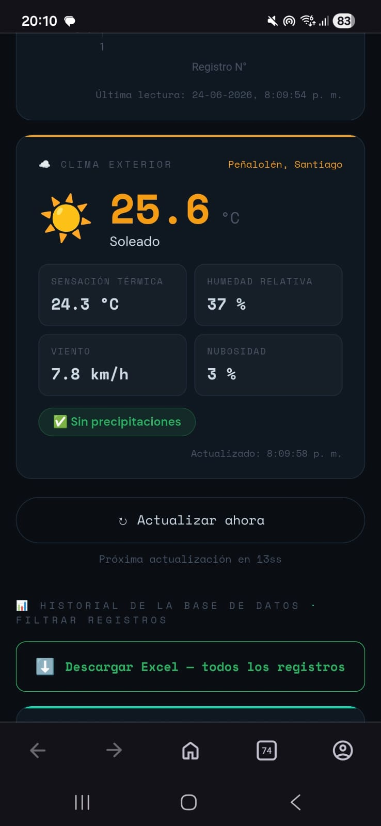
testing/Evidencias/Dashboard_4_meteorologico.jpeg
