jgarcia-dec/sensor-calidad-suelo-TEI201/testing/Evidencias/Dashboard_5_historial.jpeg

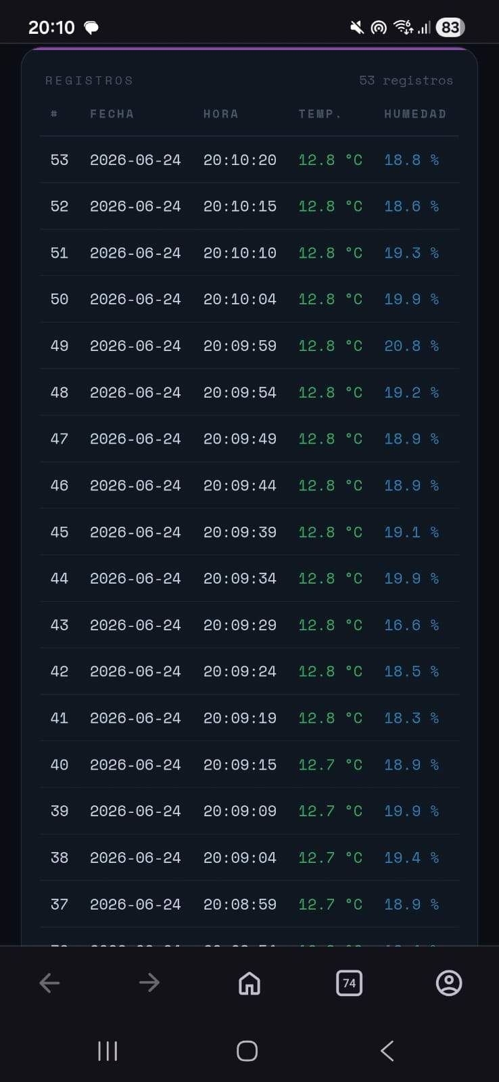
testing/Evidencias/Dashboard_5_historial.jpeg
