jgarcia-dec/sensor-calidad-suelo-TEI201/(commit log)

2026-06-24 se sube hardware
    [BOM (Software).xlsx]
2026-06-25 se suben archivos de Testing
    [monitor-suelo_25-06-2026.xlsx]
2026-06-25 se sube codigo de pagina
